asura6/ATX-PSU/ATX_PSU.kicad_pcb

## KiCad design ATX_PSU.kicad_pcb (2020-11-22)

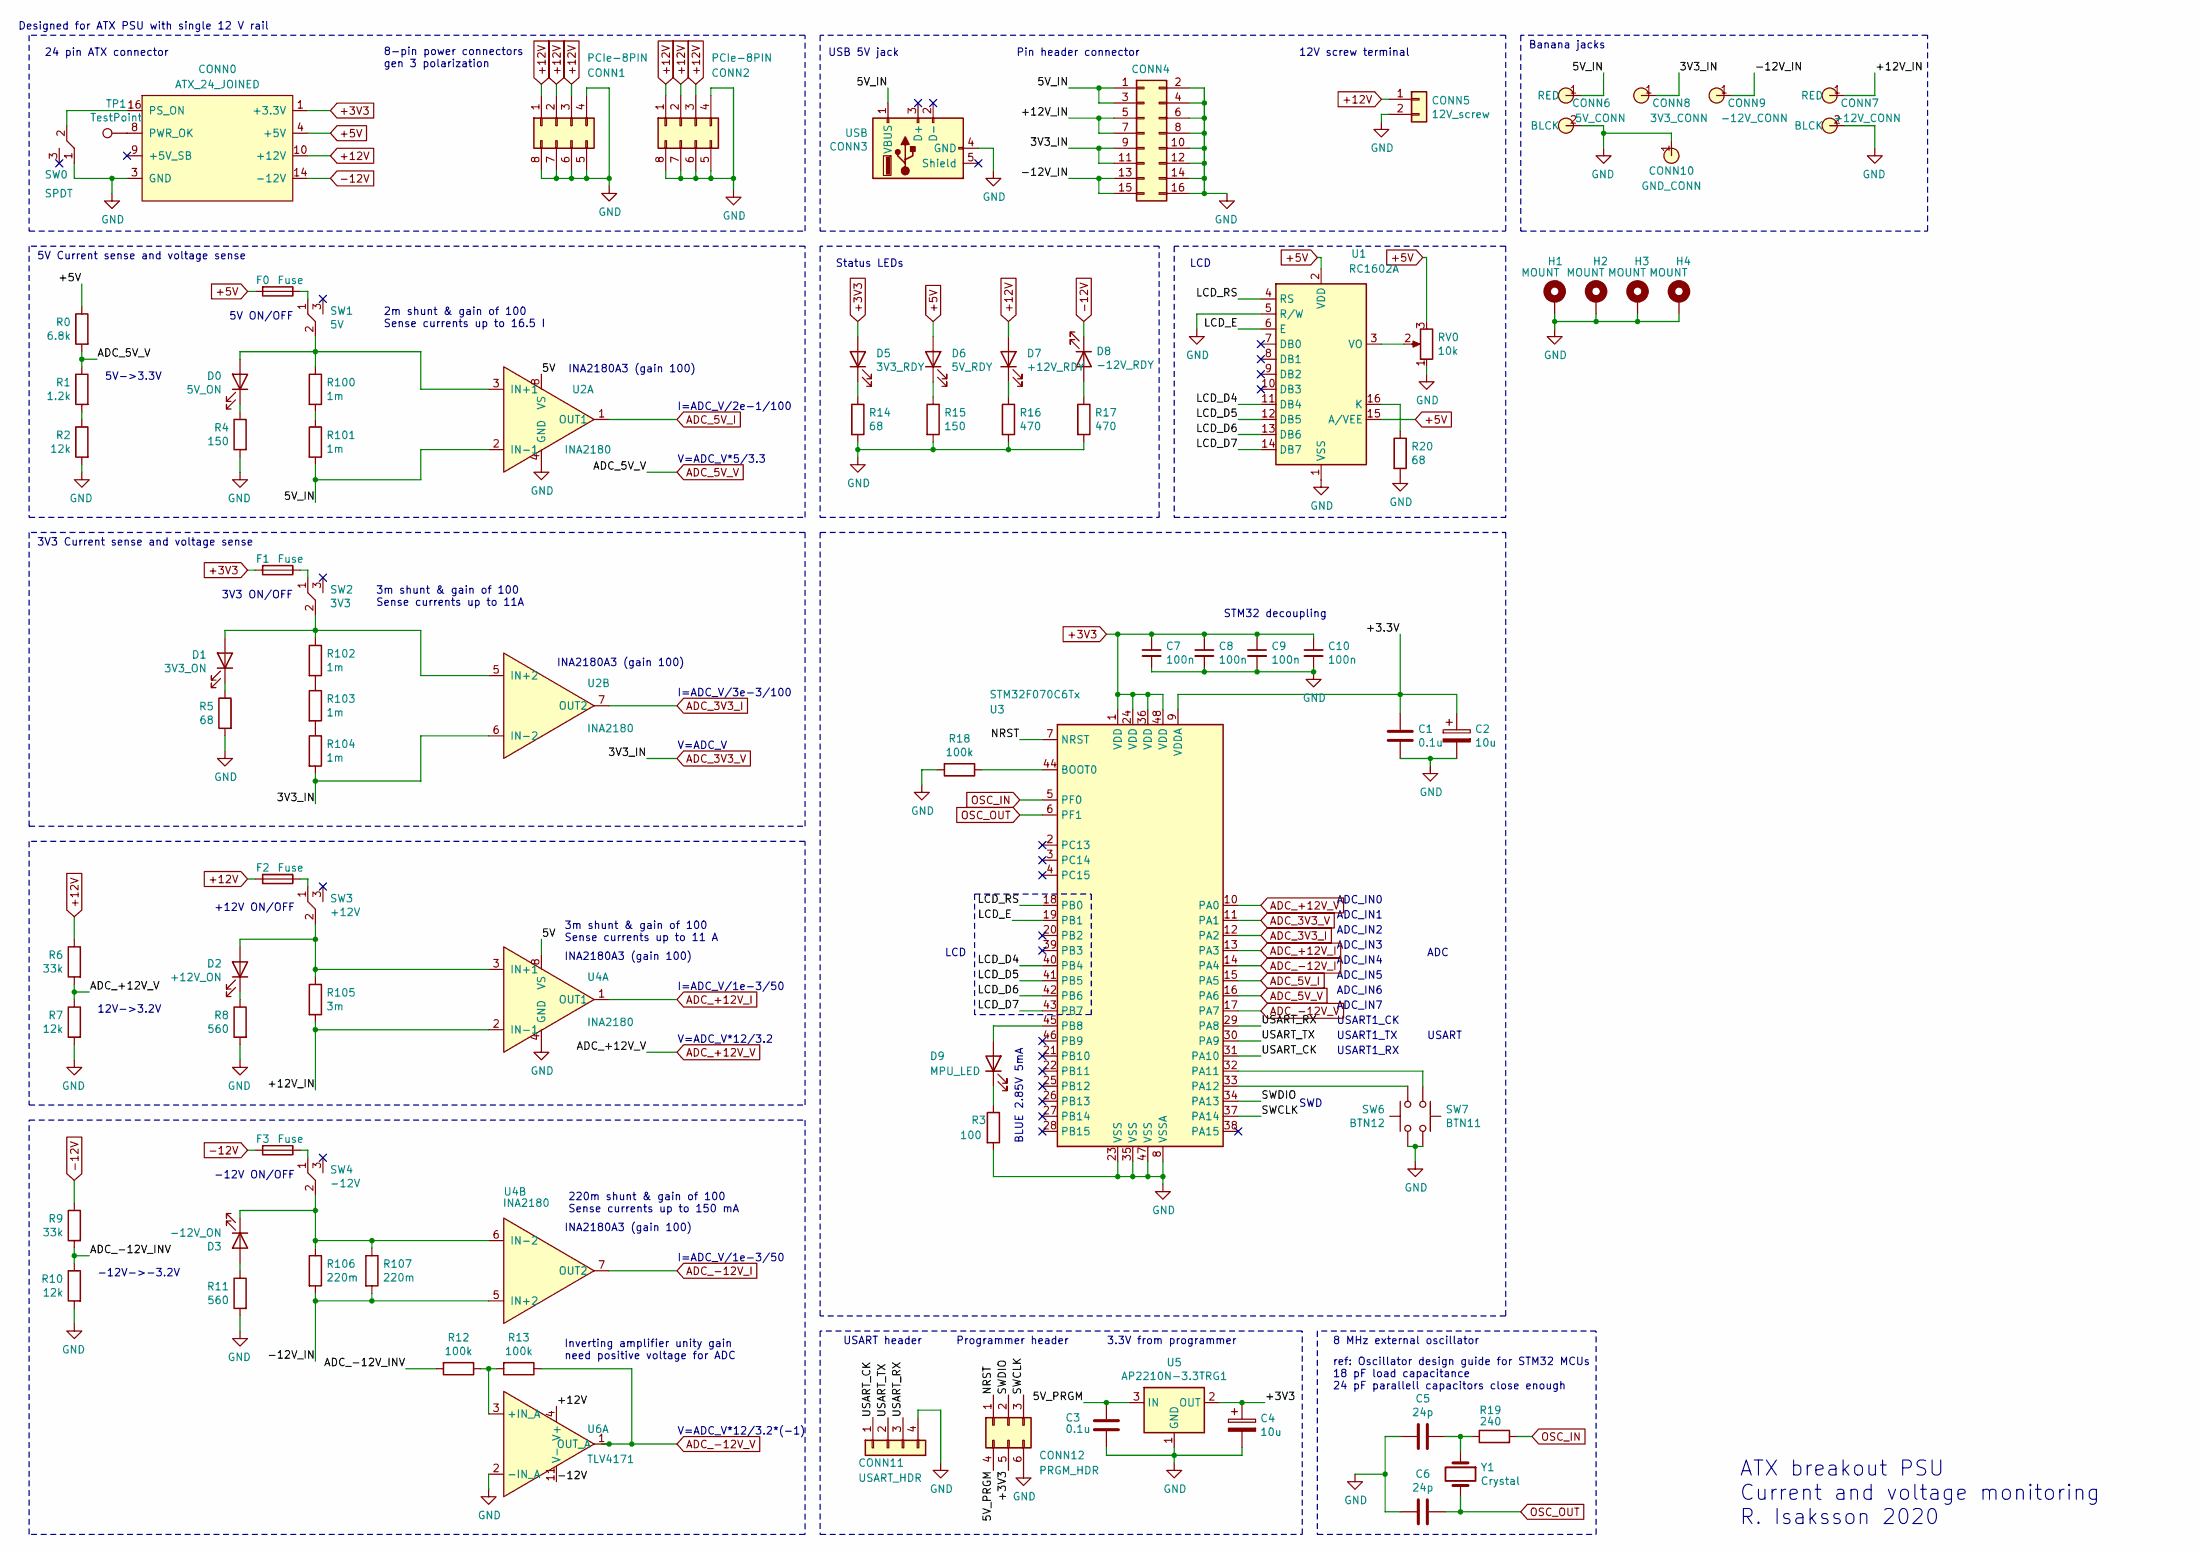
[picture p1: schematic ATX_PSU.sch]

Parts:
C1, C3: 0.1u; C_0603_1608Metric
C2, C4: 10u; CP_EIA-3528-12_Kemet-T
C5, C6: 24p; C_0603_1608Metric
C7, C8, C9, C10: 100n; C_0603_1608Metric
CONN0: ATX_24_JOINED; Molex_Mini-Fit_Jr_5569-24A2_2x12_P4.20mm_Horizontal
CONN1, CONN2: PCIe-8PIN; Molex_Mini-Fit_Jr_455860005_2x04_P4.20mm_Horizontal
CONN3: USB; USB_Micro-B_Molex_47346-0001
CONN4: Conn_02x08_Odd_Even; PinHeader_2x08_P2.54mm_Vertical
CONN5: 12V_screw; Phoenix_01x02_1935776
CONN6: 5V_CONN; 2x_BNNA
CONN7: +12V_CONN; 2x_BNNA
CONN8: 3V3_CONN; 1x_BNNA
CONN9: -12V_CONN; 1x_BNNA
CONN10: GND_CONN; 1x_BNNA
CONN11: USART_HDR; PinHeader_1x04_P2.54mm_Vertical
CONN12: PRGM_HDR; PinHeader_2x03_P2.54mm_Vertical
D0: 5V_ON; LED_1206_3216Metric
D1: 3V3_ON; LED_1206_3216Metric
D2: +12V_ON; LED_1206_3216Metric
D3: -12V_ON; LED_1206_3216Metric
D5: 3V3_RDY; LED_1206_3216Metric
D6: 5V_RDY; LED_1206_3216Metric
D7: +12V_RDY; LED_1206_3216Metric
D8: -12V_RDY; LED_1206_3216Metric
D9: MPU_LED; LED_0603_1608Metric
F0, F1, F2, F3: Fuse; Fuseholder_Cylinder-5x20mm_Stelvio-Kontek_PTF78_Horizontal_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
H1, H2, H3, H4: MOUNT; MountingHole_4.3mm_M4_Pad_Via
R0: 6.8k; R_0805_2012Metric
R1: 1.2k; R_0805_2012Metric
R2, R7, R10: 12k; R_0805_2012Metric
R3: 100; R_0805_2012Metric
R4, R15: 150; R_0805_2012Metric
R5, R14, R20: 68; R_0805_2012Metric
R6, R9: 33k; R_0805_2012Metric
R8, R11: 560; R_0805_2012Metric
R12, R13, R18: 100k; R_0805_2012Metric
R16, R17: 470; R_0805_2012Metric
R19: 240; R_0805_2012Metric
R100, R101, R102, R103, R104: 1m; R_2512_6332Metric
R105: 3m; R_1206_3216Metric
R106, R107: 220m; R_1206_3216Metric
RV0: 10k; 3361P
SW0: SPDT; RI_SPDT
SW1: 5V; RI_SPDT
SW2: 3V3; RI_SPDT
SW3: +12V; RI_SPDT
SW4: -12V; RI_SPDT
SW6: BTN12; SW_PUSH_6mm
SW7: BTN11; SW_PUSH_6mm
TP1: TestPoint; TestPoint_THTPad_2.5x2.5mm_Drill1.2mm
U1: RC1602A; LCD_4ROW
U2, U4: INA2180; VSSOP-8_3.0x3.0mm_P0.65mm
U3: STM32F070C6Tx; LQFP-48_7x7mm_P0.5mm
U5: AP2210N-3.3TRG1; SOT-23_Handsoldering
U6: TLV4171; SOIC-14_3.9x8.7mm_P1.27mm
Y1: Crystal; LFXTAL020423

Connections:
+3V3: C4.1, C7.1, C8.1, C9.1, C10.1, CONN0.1 (+3.3V), CONN0.2 (+3.3V), CONN0.12 (+3.3V), CONN0.13 (+3.3V), CONN12.5, D5.2 (A), F1.2, U3.1 (VDD), U3.24 (VDD), U3.36 (VDD), U3.48 (VDD), U5.2 (OUT)
+5V: CONN0.4 (+5V), CONN0.6 (+5V), CONN0.21 (+5V), CONN0.22 (+5V), CONN0.23 (+5V), D6.2 (A), F0.2, R0.1, RV0.3, U1.2 (VDD), U1.15 (A/VEE)
+12V: CONN0.10 (+12V), CONN0.11 (+12V), CONN1.1, CONN1.2, CONN1.3, CONN2.1, CONN2.2, CONN2.3, CONN5.1, D7.2 (A), F2.2, R6.1, U6.4 (V+)
-12V: CONN0.14 (-12V), D8.1 (K), F3.2, R9.1, U6.11 (V-)
/5V: U2.8 (VS), U4.8 (VS)
/5V_IN: CONN3.1 (VBUS), CONN4.1, CONN4.3, CONN6.1 (RED), R101.2, U2.2 (IN-1)
/5V_PRGM: C3.1, CONN12.4, U5.3 (IN)
/+3.3V: C1.1, C2.1, U3.9 (VDDA)
/+12V_IN: CONN4.5, CONN4.7, CONN7.1 (RED), R105.2, U4.2 (IN-1)
/-12V_IN: CONN4.13, CONN4.15, CONN9.1, R106.2, R107.2, U4.5 (IN+2)
/ADC_-12V_INV: R9.2, R10.1, R12.2
/LCD_D4: U1.11 (DB4), U3.40 (PB4)
/LCD_D5: U1.12 (DB5), U3.41 (PB5)
/LCD_D6: U1.13 (DB6), U3.42 (PB6)
/LCD_D7: U1.14 (DB7), U3.43 (PB7)
/LCD_E: U1.6 (E), U3.19 (PB1)
/LCD_RS: U1.4 (RS), U3.18 (PB0)
/NRST: CONN12.1, U3.7 (NRST)
/SWCLK: CONN12.3, U3.37 (PA14)
/SWDIO: CONN12.2, U3.34 (PA13)
/USART_CK: CONN11.1, U3.31 (PA10)
/USART_RX: CONN11.3, U3.29 (PA8)
/USART_TX: CONN11.2, U3.30 (PA9)
ADC_3V3_I: U2.7 (OUT2), U3.12 (PA2)
ADC_3V3_V: CONN4.9, CONN4.11, CONN8.1, R104.2, U2.6 (IN-2), U3.11 (PA1)
ADC_5V_I: U2.1 (OUT1), U3.15 (PA5)
ADC_5V_V: R0.2, R1.1, U3.16 (PA6)
ADC_+12V_I: U3.13 (PA3), U4.1 (OUT1)
ADC_+12V_V: R6.2, R7.1, U3.10 (PA0)
ADC_-12V_I: U3.14 (PA4), U4.7 (OUT2)
ADC_-12V_V: R13.1, U3.17 (PA7), U6.1 (OUT_A)
GND: C1.2, C2.2, C3.2, C4.2, C5.2, C6.2, C7.2, C8.2, C9.2, C10.2, CONN0.3 (GND), CONN0.5 (GND), CONN0.7 (GND), CONN0.15 (GND), CONN0.17 (GND), CONN0.18 (GND), CONN0.19 (GND), CONN0.24 (GND), CONN1.4, CONN1.5, CONN1.6, CONN1.7, CONN1.8, CONN2.4, CONN2.5, CONN2.6, CONN2.7, CONN2.8, CONN3.4 (GND), CONN4.2, CONN4.4, CONN4.6, CONN4.8, CONN4.10, CONN4.12, CONN4.14, CONN4.16, CONN5.2, CONN6.2 (BLCK), CONN7.2 (BLCK), CONN10.1, CONN11.4, CONN12.6, H1.1, H2.1, H3.1, H4.1, R2.2, R3.2, R4.2, R5.2, R7.2, R8.2, R10.2, R11.2, R14.2, R15.2, R16.2, R17.2, R18.2, R20.2, RV0.1, SW0.1, SW6.2, SW7.2, U1.1 (VSS), U1.5 (R/W), U2.4 (GND), U3.8 (VSSA), U3.23 (VSS), U3.35 (VSS), U3.47 (VSS), U4.4 (GND), U5.1 (GND), U6.2 (-IN_A)
unnamed: C5.1, R19.1, Y1.1
unnamed: CONN0.8 (PWR_OK), TP1.1
unnamed: CONN0.16 (PS_ON), SW0.2
unnamed: D0.1 (K), R4.1
unnamed: D0.2 (A), R100.1, SW1.2, U2.3 (IN+1)
unnamed: D1.1 (K), R5.1
unnamed: D1.2 (A), R102.1, SW2.2, U2.5 (IN+2)
unnamed: D2.1 (K), R8.1
unnamed: D2.2 (A), R105.1, SW3.2, U4.3 (IN+1)
unnamed: D3.1 (K), R106.1, R107.1, SW4.2, U4.6 (IN-2)
unnamed: D3.2 (A), R11.1
unnamed: D5.1 (K), R14.1
unnamed: D6.1 (K), R15.1
unnamed: D7.1 (K), R16.1
unnamed: D8.2 (A), R17.1
unnamed: D9.1 (K), R3.1
unnamed: D9.2 (A), U3.45 (PB8)
unnamed: F0.1, SW1.1
unnamed: F1.1, SW2.1
unnamed: F2.1, SW3.1
unnamed: F3.1, SW4.1
unnamed: R1.2, R2.1
unnamed: R12.1, R13.2, U6.3 (+IN_A)
unnamed: R18.1, U3.44 (BOOT0)
unnamed: R20.1, U1.16 (K)
unnamed: R100.2, R101.1
unnamed: R102.2, R103.1
unnamed: R103.2, R104.1
unnamed: RV0.2, U1.3 (VO)
unnamed: SW6.1, U3.33 (PA12)
unnamed: SW7.1, U3.32 (PA11)
OSC_IN: R19.2, U3.5 (PF0)
OSC_OUT: C6.1, U3.6 (PF1), Y1.2

Notes on the sheet:
24 pin ATX connector
Status LEDs
5V Current sense and voltage sense
3m shunt & gain of 100 Sense currents up to 11A
2m shunt & gain of 100 Sense currents up to 16.5 I
USB 5V jack
INA2180A3 (gain 100)
I=ADC_V/3e-3/100
V=ADC_V
I=ADC_V/2e-1/100
5V->3.3V
V=ADC_V*5/3.3
3V3 Current sense and voltage sense
12V->3.2V
V=ADC_V*12/3.2
I=ADC_V/1e-3/50
3m shunt & gain of 100 Sense currents up to 11 A
-12V->-3.2V
V=ADC_V*12/3.2*(-1)
220m shunt & gain of 100 Sense currents up to 150 mA
Inverting amplifier unity gain need positive voltage for ADC
Banana jacks
Pin header connector
Programmer header
8 MHz external oscillator
ref: Oscillator design guide for STM32 MCUs 18 pF load capacitance 24 pF parallell capacitors close enough
3.3V from programmer
ADC_IN0
ADC_IN1
ADC_IN2
ADC_IN3
ADC_IN4
ADC_IN5
ADC_IN6
ADC_IN7
USART1_CK
USART1_TX
USART1_RX
USART header
ADC
USART
LCD
SWD
STM32 decoupling
BLUE 2.85V 5mA
5V ON/OFF
3V3 ON/OFF
+12V ON/OFF
-12V ON/OFF
Designed for ATX PSU with single 12 V rail
12V screw terminal
8-pin power connectors gen 3 polarization
ATX breakout PSU Current and voltage monitoring R. Isaksson 2020

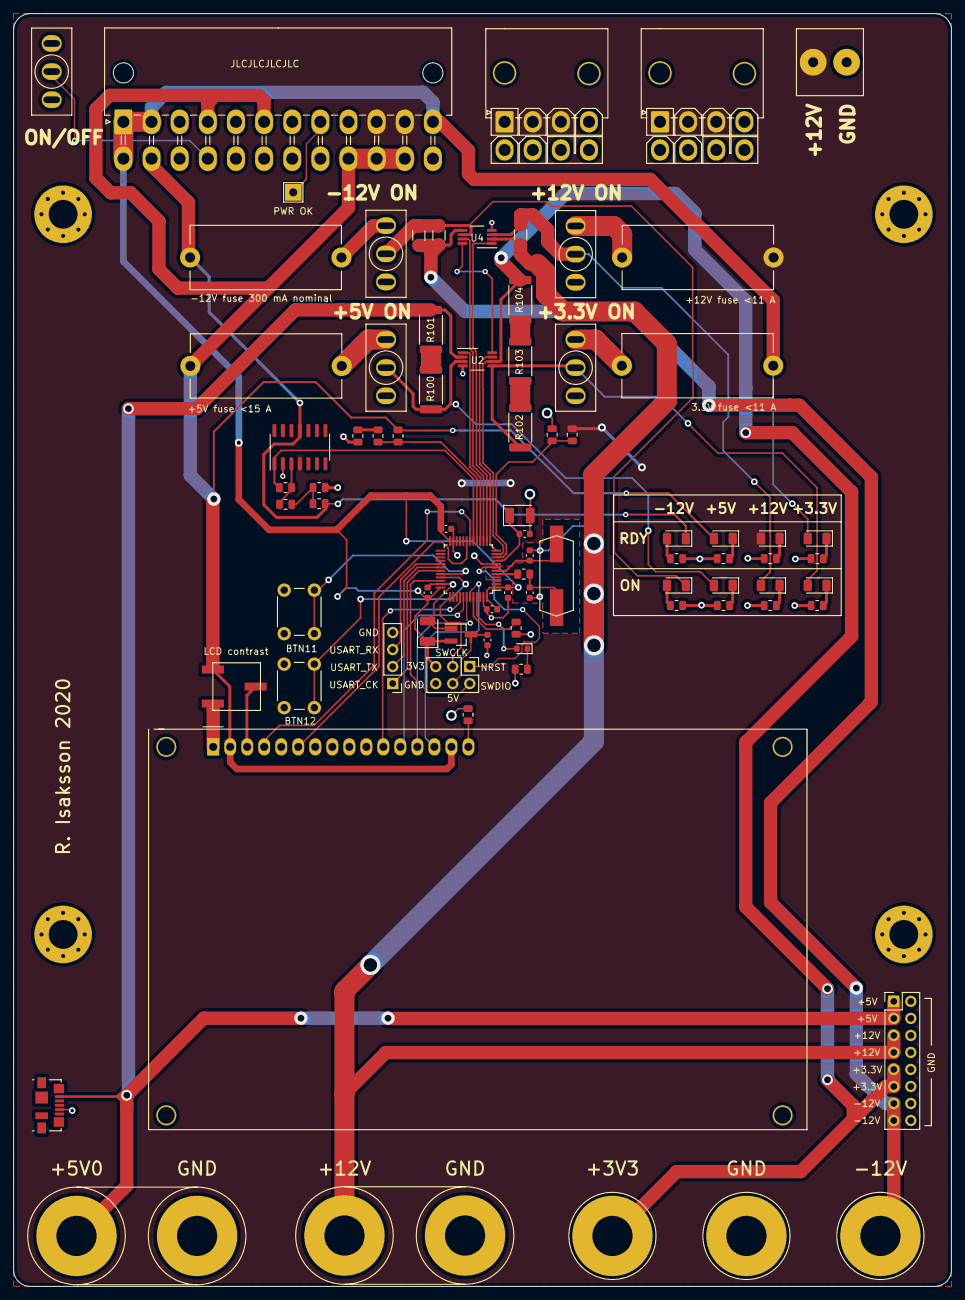
[picture p2: board ATX_PSU.kicad_pcb from above]

Board: 2 copper layers, 140.0 x 190.0 mm, 85 parts (0 on the bottom side), 65 nets.
