asura6/ATX-PSU/STM32/Src/main.c

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
/* Includes ------------------------------------------------------------------*/
#include "main.h"
#include "adc.h"
#include "usart.h"
#include "gpio.h"

/* USER CODE BEGIN Includes */
#include "UART.h"

/* USER CODE END Includes */


void SystemClock_Config(void);
/* USER CODE BEGIN 0 */
uint32_t adc_vals[2];
/* USER CODE END 0 */

/**
  * @brief  The application entry point.
  * @retval int
  */
int main(void)
{
  /* MCU Configuration--------------------------------------------------------*/

  /* Reset of all peripherals, Initializes the Flash interface and the Systick. */
  HAL_Init();

  /* Configure the system clock */
  SystemClock_Config();

  /* Initialize all configured peripherals */
  MX_GPIO_Init();
  MX_ADC_Init();
  MX_USART1_UART_Init();
  /* USER CODE BEGIN 2 */

  UART_send_str(&huart1, "System boot\r\n");
  HAL_ADC_Start_DMA(&hadc, adc_vals, 2);

  /* USER CODE END 2 */

  /* Infinite loop */
  /* USER CODE BEGIN WHILE */
  while (1)
  {
    HAL_GPIO_WritePin(GPIOB, GPIO_PIN_8, GPIO_PIN_SET);
    HAL_Delay(1U);
    HAL_GPIO_WritePin(GPIOB, GPIO_PIN_8, GPIO_PIN_RESET);

    HAL_Delay(999U);


    //HAL_ADC_Start(&hadc);
    //HAL_ADC_PollForConversion(&hadc, 1);
    //val_ADC1 = HAL_ADC_GetValue(&hadc)/(0xFFFF)*3.3f;
    //UART_send_int(&huart1, (uint16_t)val_ADC1);

    
    /* USER CODE END WHILE */

    /* USER CODE BEGIN 3 */
  }
  /* USER CODE END 3 */
}

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
