asura6/ATX-PSU/STM32/ATX_MCU.ioc

Mcu.UserName=STM32F070C6Tx
PA0.Signal=ADC_IN0
PA1.Signal=ADC_IN1
PA10.Signal=USART1_RX
PA11.Signal=GPIO_Input
PA12.Signal=GPIO_Input
PA13.Signal=SYS_SWDIO
PA14.Signal=SYS_SWCLK
PA2.Signal=ADC_IN2
PA3.Signal=ADC_IN3
PA4.Signal=ADC_IN4
PA5.Signal=ADC_IN5
PA6.Signal=ADC_IN6
PA7.Signal=ADC_IN7
PA9.Signal=USART1_TX
PB0.Signal=GPIO_Output
PB1.Signal=GPIO_Output
PB4.Signal=GPIO_Output
PB5.Signal=GPIO_Output
PB6.Signal=GPIO_Output
PB7.Signal=GPIO_Output
PB8.Signal=GPIO_Output
PF0-OSC_IN.Signal=RCC_OSC_IN
PF1-OSC_OUT.Signal=RCC_OSC_OUT
