asura6/ATX-PSU/(commit log)

2020-11-22 Flash debug scripts (jlink). UART working
2020-11-22 Working on ADC and DMA interrupt
2020-11-23 ADC prototyping
